tardani95/grabowsky_2018/01_datasheet/battery/link.txt

http://jakomodell.hu/webaruhaz/akkumulatorok/li-po-akkumulatorok/3,7v-1s-mini-li-po-akkumul%C3%A1torok/lipo-akkumul%C3%A1tor-300mah-3-7v-turnigy-nano-tech-detail
