tardani95/grabowsky_2018/03_hardware/v3_mcu.pdf

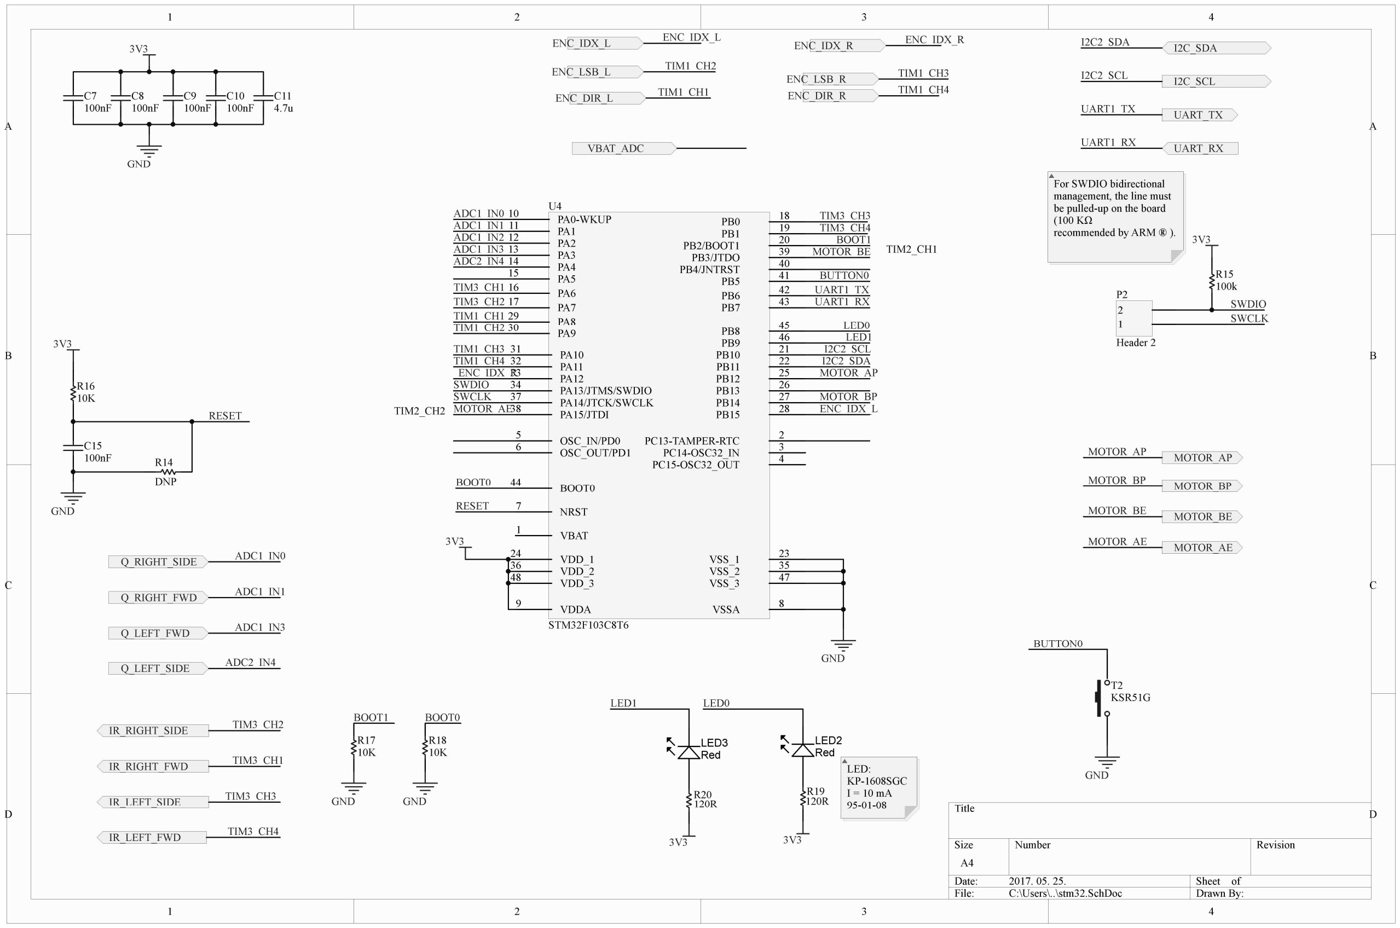
[picture p1: page 1]

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
Title

Size | Number | Revision
A4
Date: | 2017. 05. 25. | Sheet of
File: | C:\Users\..\stm32.SchDoc | Drawn By:

GND

I2C_SDA

I2C_SCL

3V3

3V3

GND

GND

3V3

RESET

R16
10K

C15
100nF

C7
100nF

C8
100nF

C9
100nF

C10
100nF

C11
4.7u

UART_RX

UART_TX

I2C2_SCL

I2C2_SDA

UART1_RX

UART1_TX

SWCLK

SWDIO

MOTOR_AE

MOTOR_BE

MOTOR_BP

MOTOR_AP

ADC1_IN0

ADC1_IN1

ADC1_IN3

TIM3_CH1

TIM3_CH2

TIM3_CH3

TIM3_CH4

MOTOR_AP

MOTOR_AE

MOTOR_BP

MOTOR_BE

LED0

GND
R19
120R

BUTTON0

GND | GND

Q_RIGHT_SIDE

Q_RIGHT_FWD

Q_LEFT_FWD

Q_LEFT_SIDE

IR_LEFT_SIDE

IR_LEFT_FWD

IR_RIGHT_FWD

IR_RIGHT_SIDE

3V3

R15
100k

R17
10K

R18
10K

T2
KSR51G
BOOT0

BOOT0 44

NRST 7

OSC_IN/PD0 5
OSC_OUT/PD1 6

PA0-WKUP 10
PA1 11
PA2 12
PA3 13
PA4 14
PA5 15
PA6 16
PA7 17
PA8 29
PA9 30

PA10 31
PA11 32
PA12 33
PA13/JTMS/SWDIO 34
PA14/JTCK/SWCLK 37
PA15/JTDI 38
PB0 | 18
PB1 | 19
PB2/BOOT1 | 20
PB3/JTDO | 39
PB4/JNTRST | 40
PB5 | 41
PB6 | 42
PB7 | 43
PB8 | 45
PB9 | 46
PB10 | 21
PB11 | 22
PB12 | 25
PB13 | 26
PB14 | 27
PB15 | 28
PC13-TAMPER-RTC | 2
PC14-OSC32_IN | 3
PC15-OSC32_OUT | 4

VBAT 1

VDD_1 24
VDD_2 36
VDD_3 48

VDDA 9

VSS_1 | 23
VSS_2 | 35
VSS_3 | 47
VSSA | 8

U4

STM32F103C8T6

BOOT1

LED1

R20
120R

ENC_IDX_L

ENC_LSB_L

ENC_DIR_L

ENC_IDX_R

ENC_LSB_R
ENC_DIR_R

TIM1_CH2

TIM1_CH1

VBAT_ADC

ADC2_IN4

LED3
Red

LED2
Red

1

2

P2

Header 2

ENC_IDX_R

RESET

ADC1_IN0
ADC1_IN1
ADC1_IN2
ADC1_IN3
ADC2_IN4

TIM3_CH1
TIM3_CH2

TIM3_CH3
TIM3_CH4
BOOT1

I2C2_SCL
I2C2_SDA

MOTOR_BE

MOTOR_BP

MOTOR_AP

MOTOR_AE

BUTTON0

SWDIO
SWCLK

UART1_TX
UART1_RX

BOOT0

LED0
LED1
3V3 | 3V3

ENC_IDX_L

R14
DNP

TIM1_CH1
TIM1_CH2

TIM1_CH3
TIM1_CH4

TIM1_CH3
TIM1_CH4
ENC_IDX_L | ENC_IDX_R

TIM2_CH2

TIM2_CH1

LED:
KP-1608SGC
I = 10 mA
95-01-08

For SWDIO bidirectional
management, the line must
be pulled-up on the board
(100 KΩ
recommended by ARM ® ).
