tardani95/grabowsky_2018/01_datasheet/bearing_681.PNG

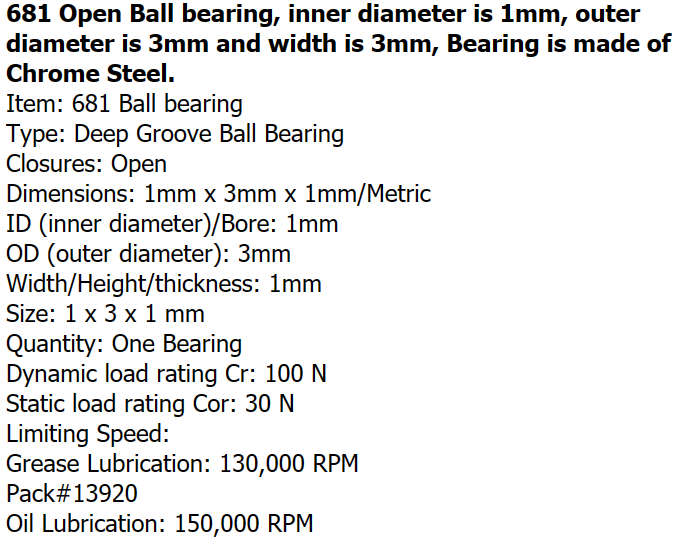
01_datasheet/bearing_681.PNG
