tardani95/grabowsky_2018/01_datasheet/peti/STM32F103xx_LQFP64_pinout.PNG

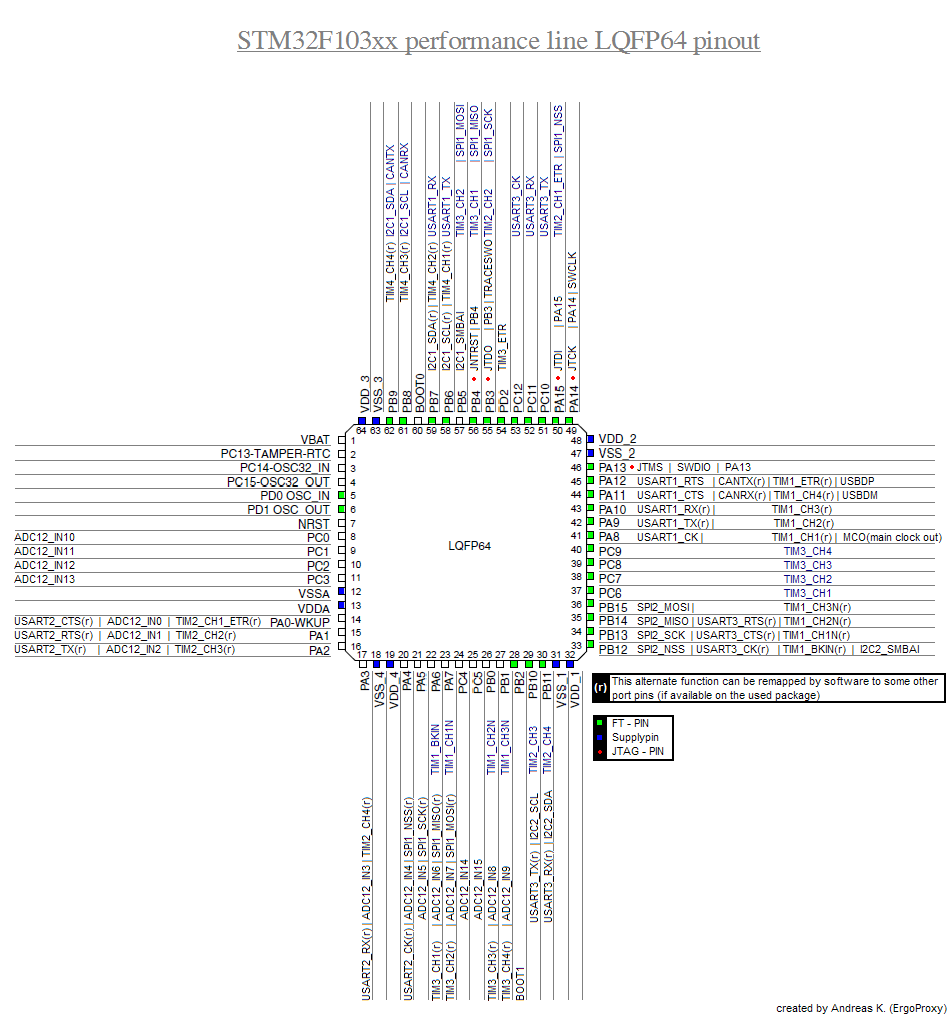
01_datasheet/peti/STM32F103xx_LQFP64_pinout.PNG
