tardani95/grabowsky_2018/02_doc/PartList_Intermouse.xlsm

Intermouse 2017
Alkatrész attribútumok |  |  |  | Költségkalkuláció |  |  |  |  | Beszerzés
Alkatrész | Value | Tokozás | SMD/TH | db /termék | Nett. alkatrész ár | Össz nett alkatrész ár | Össz nett ktg. | Készlet értéke | Beszállító | Cikkszám | Megjegyzés | Link
STM32F103C8T6 (http://hu.mouser.com/ProductDetail/STMicroelectronics/STM32F103C8T6/) |  | LQFP48 | SMD | 2 db | 1800.00 Ft | 3600.00 Ft |  | #REF! | Farnell | STM32F103C8T6 | ok | http://hu.farnell.com/stmicroelectronics/stm32f103c8t6/mcu-32bit-cortex-m3-72mhz-lqfp/dp/1447637?exaMfpn=true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
 |  |  |  |  |  |  |  | #REF!
MPU6050 (https://store.invensense.com/ProductDetail/MPU-6050-InvenSense-Inc/422200/pid=1135) |  | QFN24 | SMD | 2 db | 2280.00 Ft | 4560.00 Ft |  |  | Farnell | MPU-6050 | Van a fiókban, megvan | http://hu.farnell.com/invensense/mpu-6050/gyro-accel-6-axis-i2c-qfn-24/dp/1864742
DRV8836DSSR (https://store.ti.com/DRV8836DSSR.aspx) |  | WSON(DSS) 12 | SMD | 1 db | 580.00 Ft | 580.00 Ft |  |  | Texas Instruments | DRV8836DSSR | ha rosszul sikerulne a forrasztas, 1 mar van | https://store.ti.com/DRV8836DSSR.aspx
a mikrokontrollert es a mpu6050-t szukseg eseten ki tudjuk dev-boardokbol is forrasztani
SFH4545 (http://hu.mouser.com/ProductDetail/OSRAM-Opto-Semiconductors/SFH-4545/) |  |  | TH | 6 db | 171.00 Ft | 1026.00 Ft |  |  | Mouser | 720-SFH4545 | ok | http://hu.mouser.com/ProductDetail/OSRAM-Opto-Semiconductors/SFH-4545/
LTR4206 (http://hu.mouser.com/ProductDetail/Lite-On/LTR-4206/) |  |  | TH | 6 db | 41.00 Ft | 246.00 Ft |  |  | Mouser | 859-LTR-4206 | ok | http://hu.mouser.com/ProductDetail/Lite-On/LTR-4206/
 |  |  |  |  |  |  |  | #REF!
 |  |  |  |  |  |  |  | #REF!
 |  |  |  |  |  | 10012.00 Ft | 0.00 Ft | #REF!
 |  | dbSMD: | 3 db
 |  | dbTH: | 2 db
