tardani95/grabowsky_2018/03_hardware/3D/gearbox_v2/_ASSEMBLY_getriebe_rechts.SLDASM

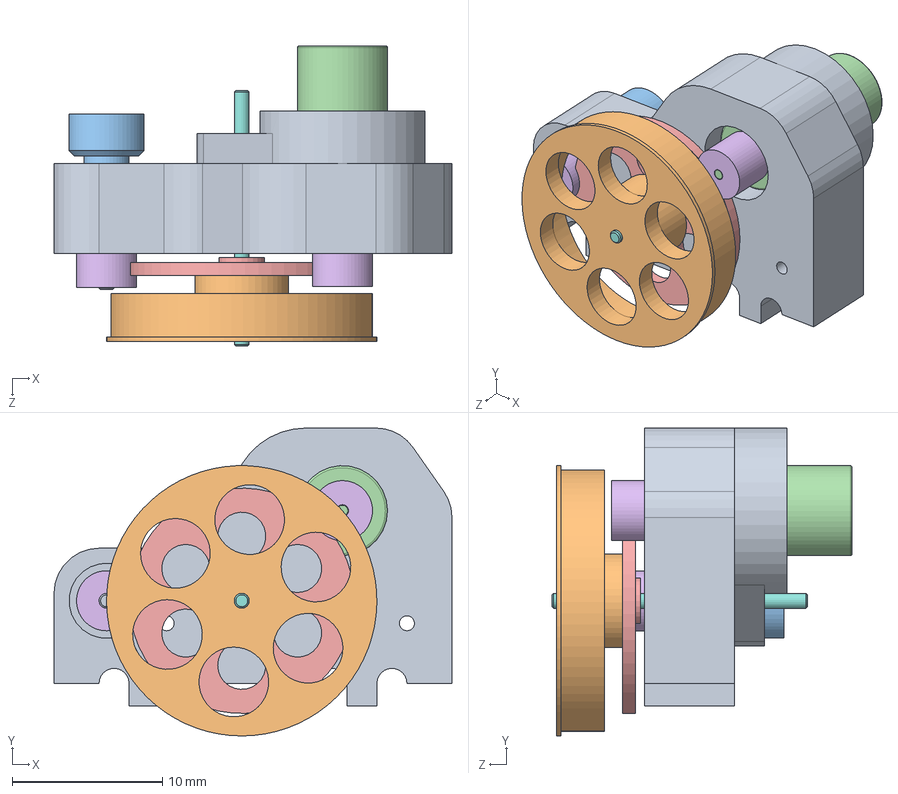
[picture p5: CAD file, 2018-09-10]
03_hardware/3D/gearbox_v2/_ASSEMBLY_getriebe_rechts.SLDASM
26.5 x 20.5 x 20.0 mm
getriebe_gehause_rechts
magnetscheibe
magnettraeger
MK06_4R5_1
grossRad
ritzel x 2
rillenkugellager_6488 x 4
hauptWelle
nebenWelle
rad
