tardani95/grabowsky_2018/03_hardware/3D/gearbox_v2/getriebe_gehause_links.SLDPRT

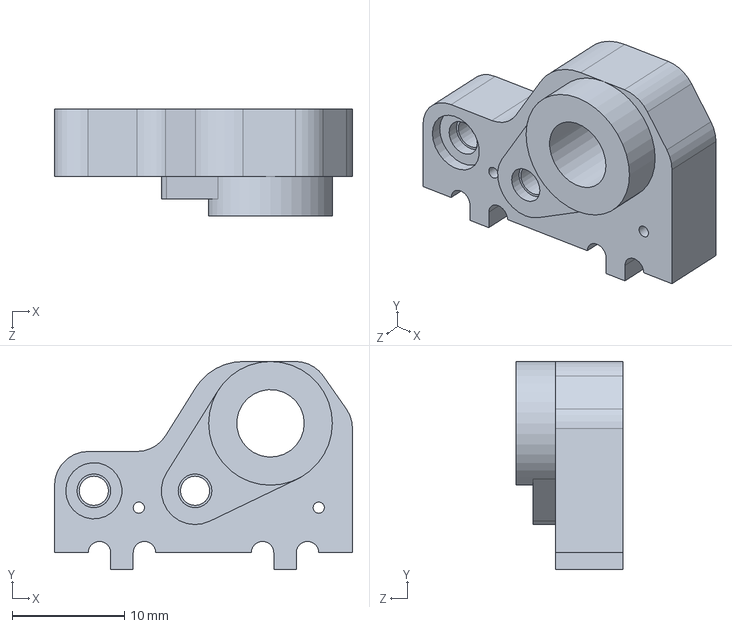
[picture p6: CAD file, 2018-09-10]
03_hardware/3D/gearbox_v2/getriebe_gehause_links.SLDPRT
26.5 x 18.5 x 9.50 mm
