tardani95/grabowsky_2018/03_hardware/3D/gearbox_v2/maratas_intermouse/haz/getriebe_gehause_links_1.STEP

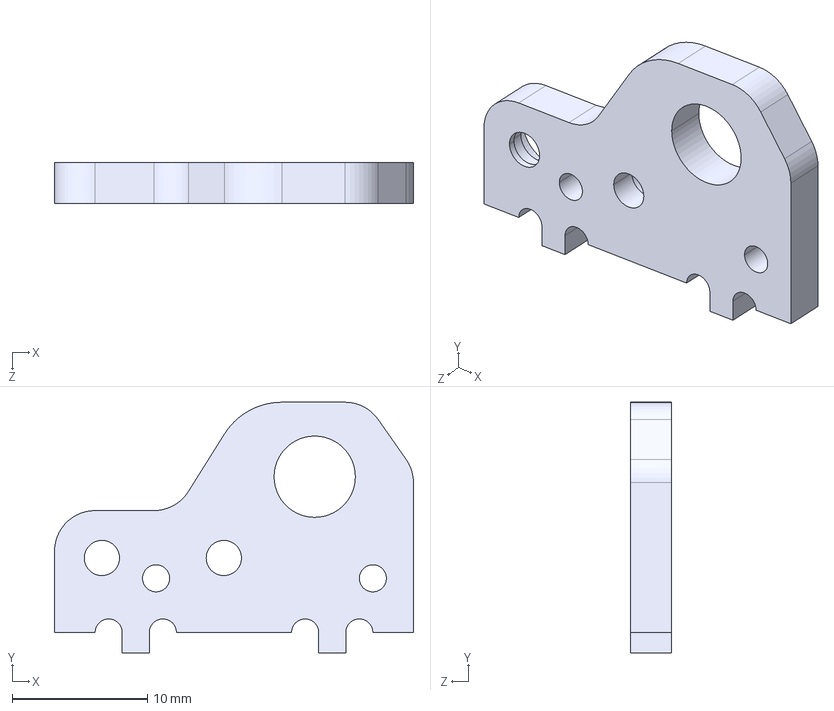
[picture p7: CAD file, 2018-09-10]
03_hardware/3D/gearbox_v2/maratas_intermouse/haz/getriebe_gehause_links_1.STEP
26.5 x 18.5 x 3.00 mm
