tardani95/grabowsky_2018/03_hardware/3D/gearbox_v2/maratas_intermouse/kerek/rad.STEP

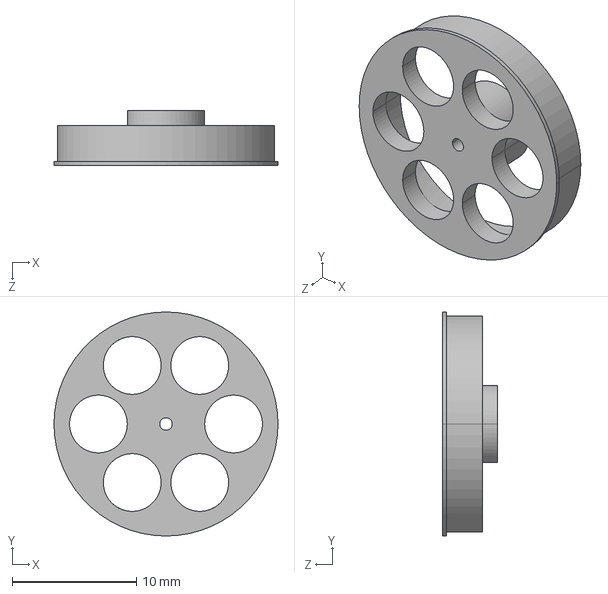
[picture p8: CAD file, 2018-09-10]
03_hardware/3D/gearbox_v2/maratas_intermouse/kerek/rad.STEP
18.0 x 18.0 x 4.40 mm
