tardani95/grabowsky_2018/03_hardware/3D/gearbox_v2/maratas_intermouse/magnestarto/magnettraeger_aussen.STEP

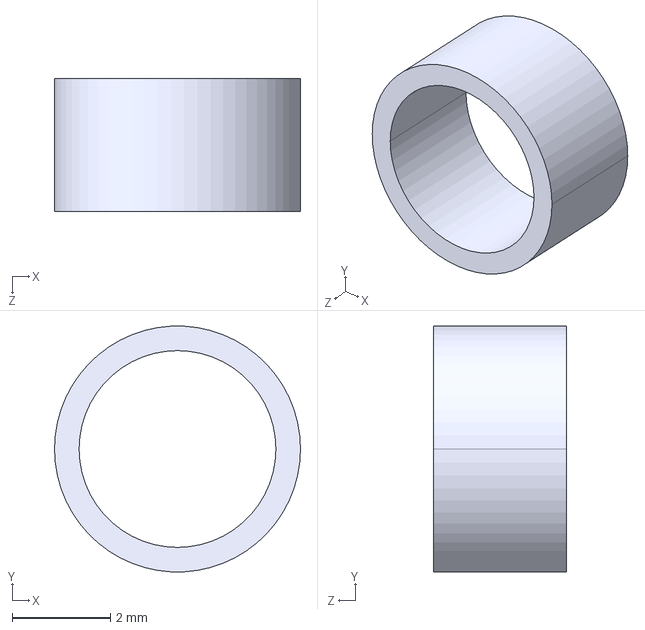
[picture p9: CAD file, 2018-09-10]
03_hardware/3D/gearbox_v2/maratas_intermouse/magnestarto/magnettraeger_aussen.STEP
5.00 x 4.99 x 2.70 mm
