tardani95/grabowsky_2018/03_hardware/3D/photoTr_irLed/led_holder_v13.stl

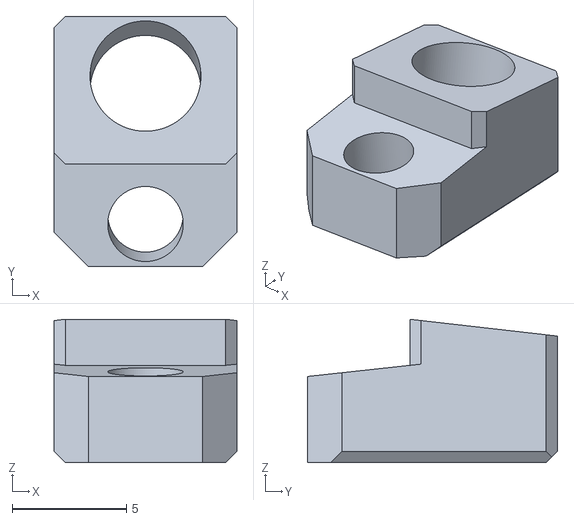
[picture p10: CAD file, 2018-09-27]
03_hardware/3D/photoTr_irLed/led_holder_v13.stl
8.00 x 10.9 x 6.27
