tardani95/grabowsky_2018/03_hardware/3D/step_files/gearbox_housing_l.STEP

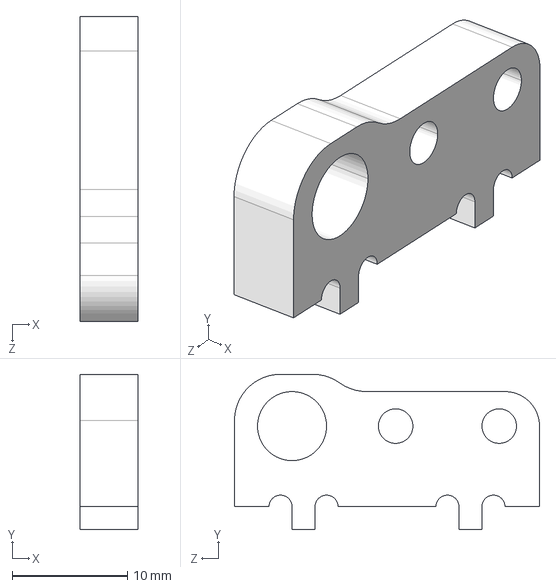
[picture p11: CAD file, 2018-09-10]
03_hardware/3D/step_files/gearbox_housing_l.STEP
5.00 x 13.5 x 26.5 mm
