tardani95/grabowsky_2018/03_hardware/3D/gearbox_v2/maratas_intermouse/magnestarto/magnettraeger_innen.STEP

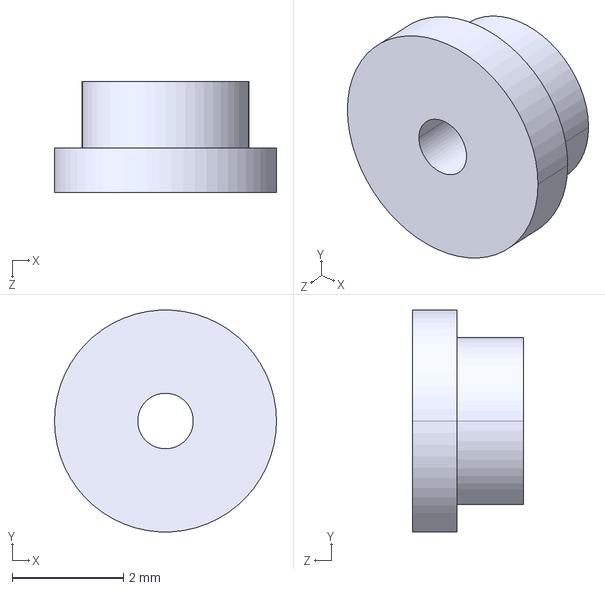
[picture p13: CAD file, 2018-09-10]
03_hardware/3D/gearbox_v2/maratas_intermouse/magnestarto/magnettraeger_innen.STEP
4.00 x 3.99 x 2.00 mm
