tardani95/grabowsky_2018/03_hardware/3D/gearbox_v2/rillenkugellager_6488.SLDPRT

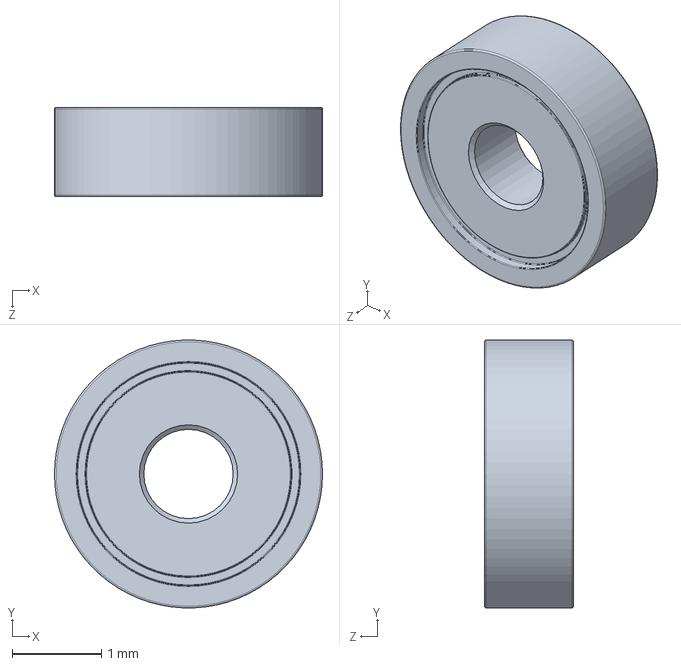
[picture p14: CAD file, 2018-09-10]
03_hardware/3D/gearbox_v2/rillenkugellager_6488.SLDPRT
3.00 x 3.00 x 1 mm
