tardani95/grabowsky_2018/03_hardware/3D/photoTr_irLed/ir_cover_v10.stl

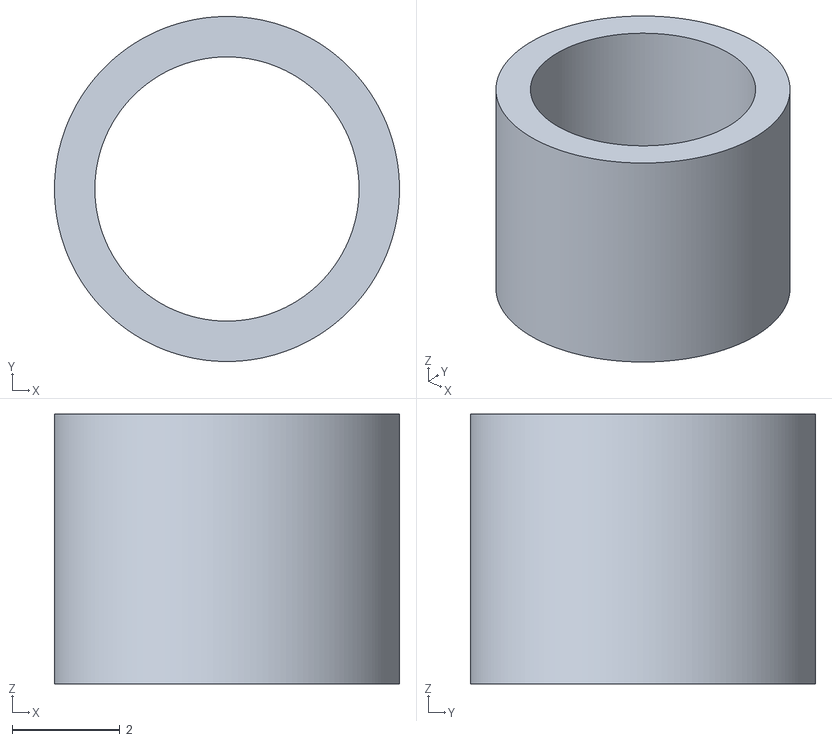
[picture p15: CAD file, 2018-09-27]
03_hardware/3D/photoTr_irLed/ir_cover_v10.stl
6.40 x 6.40 x 5.00
