tardani95/grabowsky_2018/03_hardware/3D/step_files/wheel.STEP

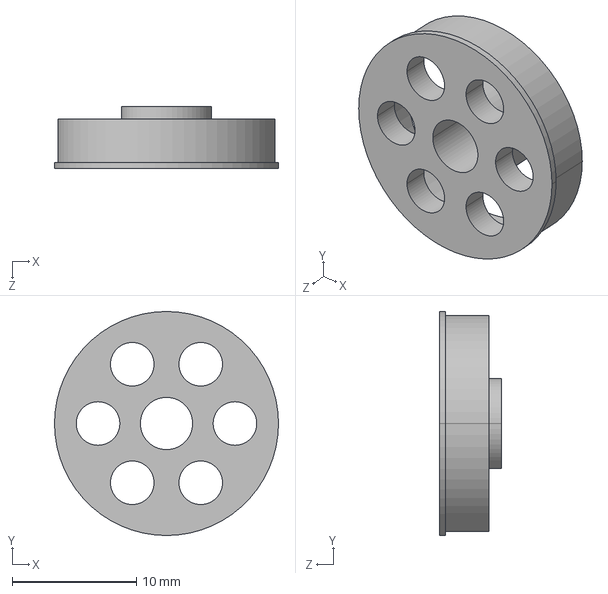
[picture p16: CAD file, 2018-09-10]
03_hardware/3D/step_files/wheel.STEP
18.0 x 18.0 x 5.00 mm
