tardani95/grabowsky_2018/03_hardware/3D/step_files/Magnetplate.STEP

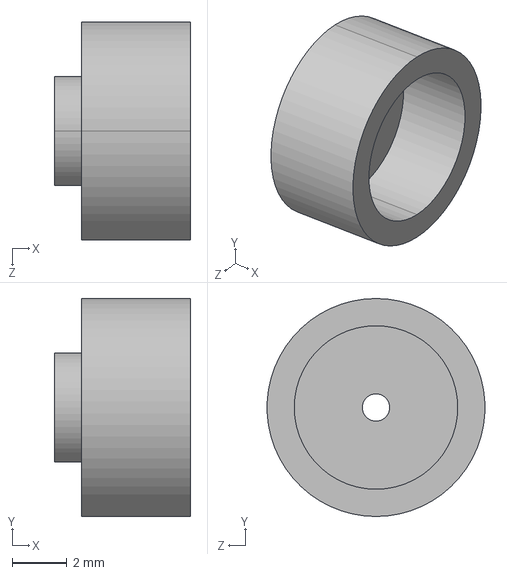
[picture p17: CAD file, 2018-09-10]
03_hardware/3D/step_files/Magnetplate.STEP
5.00 x 8.00 x 7.99 mm
