tardani95/grabowsky_2018/03_hardware/3D/photoTr_irLed/ptr_cover_v12.stl

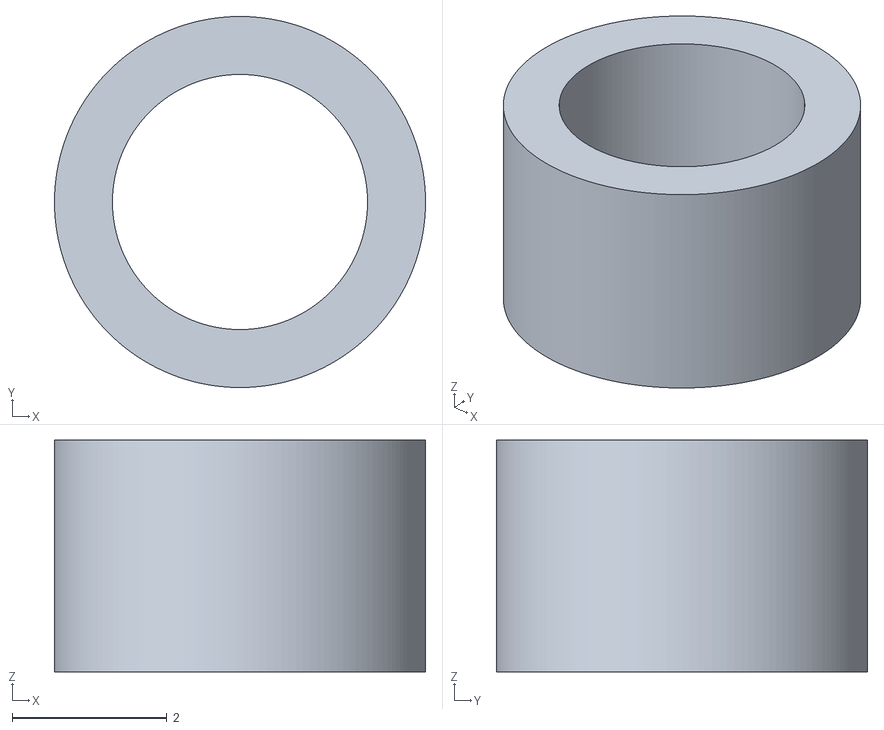
[picture p18: CAD file, 2018-09-27]
03_hardware/3D/photoTr_irLed/ptr_cover_v12.stl
4.80 x 4.80 x 3.00
