tardani95/grabowsky_2018/03_hardware/3D/gearbox_v2/MK06_4R5_1.SLDPRT

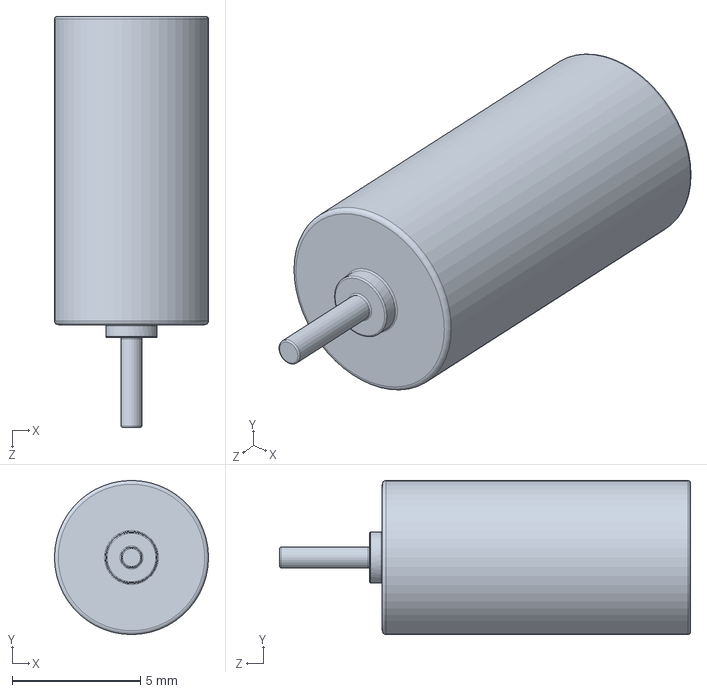
[picture p19: CAD file, 2018-09-10]
03_hardware/3D/gearbox_v2/MK06_4R5_1.SLDPRT
6.00 x 6.00 x 16.0 mm
