tardani95/grabowsky_2018/03_hardware/3D/gearbox_v2/grossRad.SLDPRT

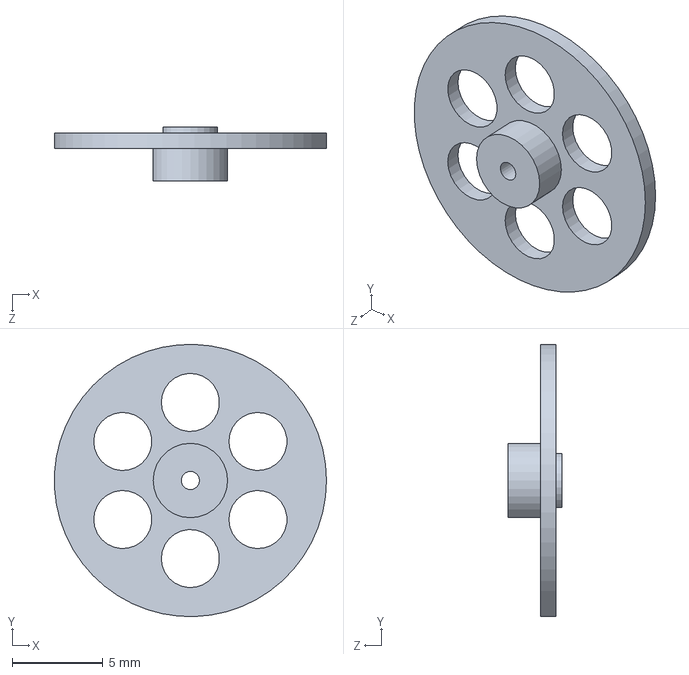
[picture p20: CAD file, 2018-09-10]
03_hardware/3D/gearbox_v2/grossRad.SLDPRT
15.0 x 15.0 x 3.00 mm
