tardani95/grabowsky_2018/03_hardware/3D/gearbox_v2/hauptWelle.SLDPRT

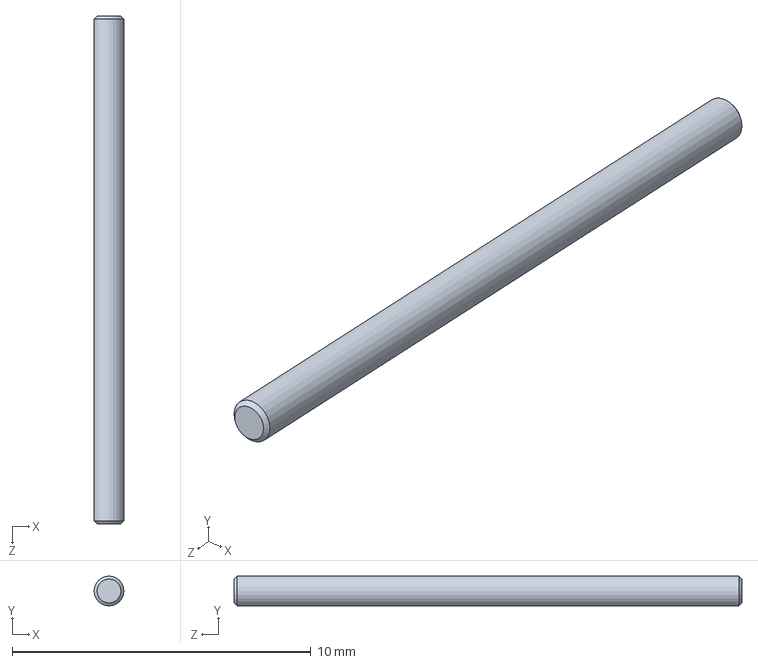
[picture p21: CAD file, 2018-09-10]
03_hardware/3D/gearbox_v2/hauptWelle.SLDPRT
1.00 x 1.00 x 17.0 mm
