tardani95/grabowsky_2018/03_hardware/3D/gearbox_v2/magnettraeger.SLDPRT

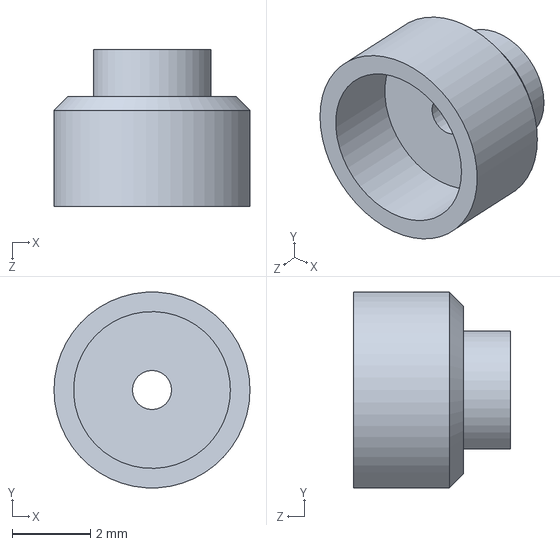
[picture p22: CAD file, 2018-09-10]
03_hardware/3D/gearbox_v2/magnettraeger.SLDPRT
5.00 x 4.99 x 4.00 mm
