tardani95/grabowsky_2018/03_hardware/3D/gearbox_v2/magnetscheibe.SLDPRT

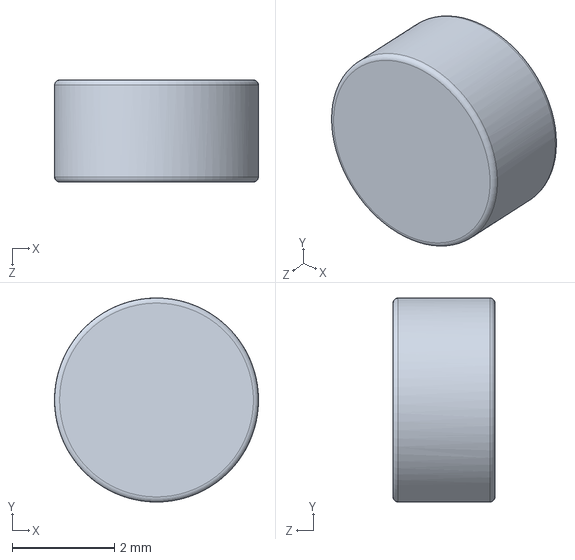
[picture p23: CAD file, 2018-09-10]
03_hardware/3D/gearbox_v2/magnetscheibe.SLDPRT
4.00 x 4.00 x 2.00 mm
