tardani95/grabowsky_2018/03_hardware/3D/gearbox_v2/ritzel.SLDPRT

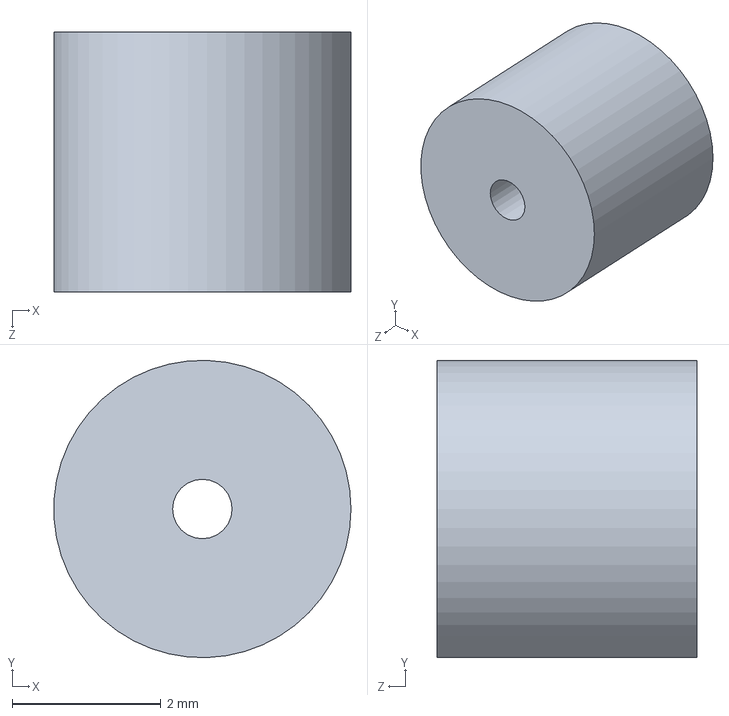
[picture p24: CAD file, 2018-09-10]
03_hardware/3D/gearbox_v2/ritzel.SLDPRT
4.00 x 4.00 x 3.50 mm
