tardani95/grabowsky_2018/03_hardware/3D/gearbox_v2/nebenWelle.SLDPRT

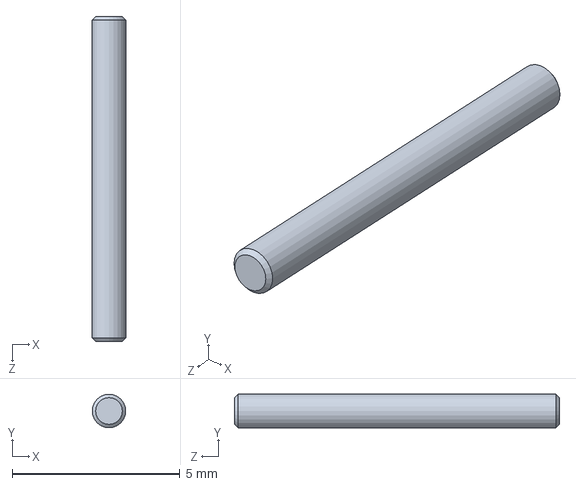
[picture p25: CAD file, 2018-09-10]
03_hardware/3D/gearbox_v2/nebenWelle.SLDPRT
1.00 x 1.00 x 9.70 mm
