tardani95/grabowsky_2018/(list of files, cad)

Other CAD files:
03_hardware/3D/gearbox_v2/getriebe_gehause_rechts.SLDPRT
03_hardware/3D/gearbox_v2/maratas_intermouse/haz/getriebe_gehause_rechts_2.STEP
03_hardware/3D/gearbox_v2/maratas_intermouse/haz/getriebe_gehause_rechts_1.STEP
03_hardware/3D/gearbox_v2/maratas_intermouse/STEP_fajlok/getriebe_gehause_rechts_1.STEP
03_hardware/3D/gearbox_v2/maratas_intermouse/STEP_fajlok/getriebe_gehause_rechts_2.STEP
03_hardware/3D/gearbox_v2/rad.SLDPRT
03_hardware/3D/gearbox_v2/maratas_intermouse/haz/getriebe_gehause_links_1.SLDPRT
03_hardware/3D/gearbox_v2/maratas_intermouse/haz/getriebe_gehause_links_2.SLDPRT
03_hardware/3D/gearbox_v2/maratas_intermouse/haz/getriebe_gehause_rechts_1.SLDPRT
03_hardware/3D/gearbox_v2/maratas_intermouse/haz/getriebe_gehause_rechts_2.SLDPRT
03_hardware/3D/gearbox_v2/maratas_intermouse/kerek/rad.SLDPRT
03_hardware/3D/gearbox_v2/maratas_intermouse/magnestarto/magnettraeger_aussen.SLDPRT
03_hardware/3D/gearbox_v2/maratas_intermouse/magnestarto/magnettraeger_innen.SLDPRT
03_hardware/3D/photoTr_irLed/led_holder_v11.stl
03_hardware/3D/photoTr_irLed/led_holder_v12.stl
03_hardware/3D/photoTr_irLed/ptr_cover_v1.stl
03_hardware/3D/photoTr_irLed/ptr_cover_v11.stl
03_hardware/3D/step_files/gearbox_housing_l.SLDPRT
