tardani95/grabowsky_2018/(commit log)

2018-09-10 project directory updated with usefull data
    [MK06_4R5_1.SLDPRT, Magnetplate.STEP, PartList_Intermouse.xlsm, _ASSEMBLY_getriebe_rechts.SLDASM, elozetes_alkatreszlista.xlsx, gearbox_housing_l.SLDPRT, gearbox_housing_l.STEP, getriebe_gehause_links.SLDPRT]
2018-09-10 motor speeds set to zero - to test encoder
2018-09-10 encoder interface not working because the A and B channel is connected
    [main.c]
2018-09-10 encoder and button handling done
2018-09-10 button handling quickfix
2018-09-10 i2c preparation - init functions
2018-09-14 missing function prototype added
2018-09-15 function prototype fix, saveMaze function extended with return value
2018-09-15 safty brackets added
2018-09-16 bool type replaced with uint8 - true/false defines - dma handling prepared
2018-09-16 mpu6050 data reading works - correctness should be tested
    [main.c]
2018-09-16 renamed functions, fixed comments
    [main.c]
2018-09-17 pin renames, long functions taken appart into smaller ones
2018-09-24 timer and debug init functions moved to another place
2018-09-24 mpu6050 solder test 01 - failed
    [main.c]
2018-09-26 led holder 3d modelled in Inventor
    [led_holder_v11.dwg]
2018-09-26 model changed to stl format
    [led_holder_v11.dwg, led_holder_v11.stl]
2018-09-27 with button0 reset encoder values - glitch in signal line - maybe fatal error
2018-09-27 heartbeat and other leds switched off
2018-09-27 led holder stl files added
    [holder_test.0005.ipt, holder_test.ipt, ir_cover_v10.stl, led_holder_v12.stl, led_holder_v13.stl, ptr_cover_v1.stl, ptr_cover_v11.stl, ptr_cover_v12.stl]
2018-09-30 6050_test without dma
2018-09-30 mpu6050 i2c works with dma
2018-09-30 mpu6050 raw readings works with dma - control loop @0.5kHz
2018-10-01 button control for start and stop moves
2018-10-01 control loop changed base to encoder
2018-10-01 motor pins corrected
2018-10-01 heartbeat switched on
2018-10-01 tuning control parameters based on ir leds and photo transistors
